h4rryhaller/jarduino/IMG_20260922_170826.jpg

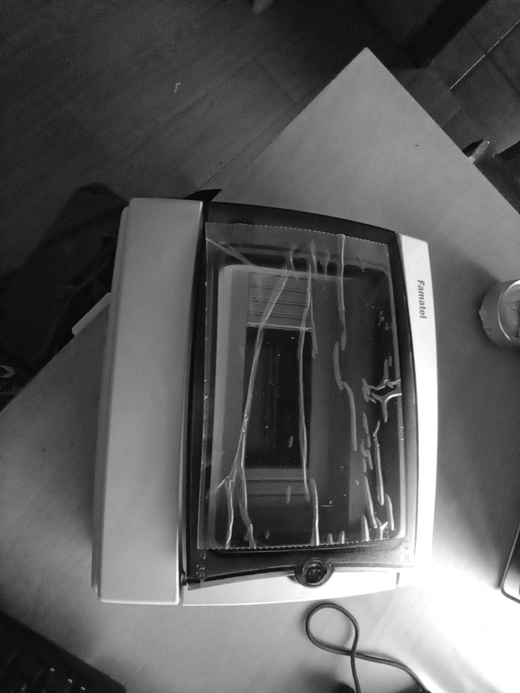
IMG_20260922_170826.jpg
