h4rryhaller/jarduino/IMG_20260922_170915.jpg

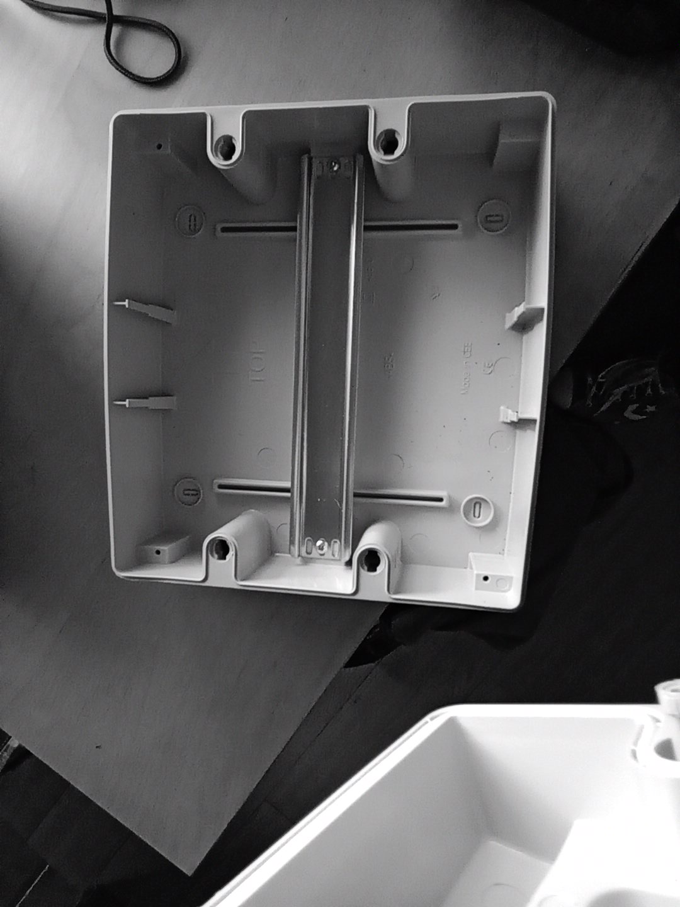
IMG_20260922_170915.jpg
