h4rryhaller/jarduino/IMG_20260922_170907.jpg

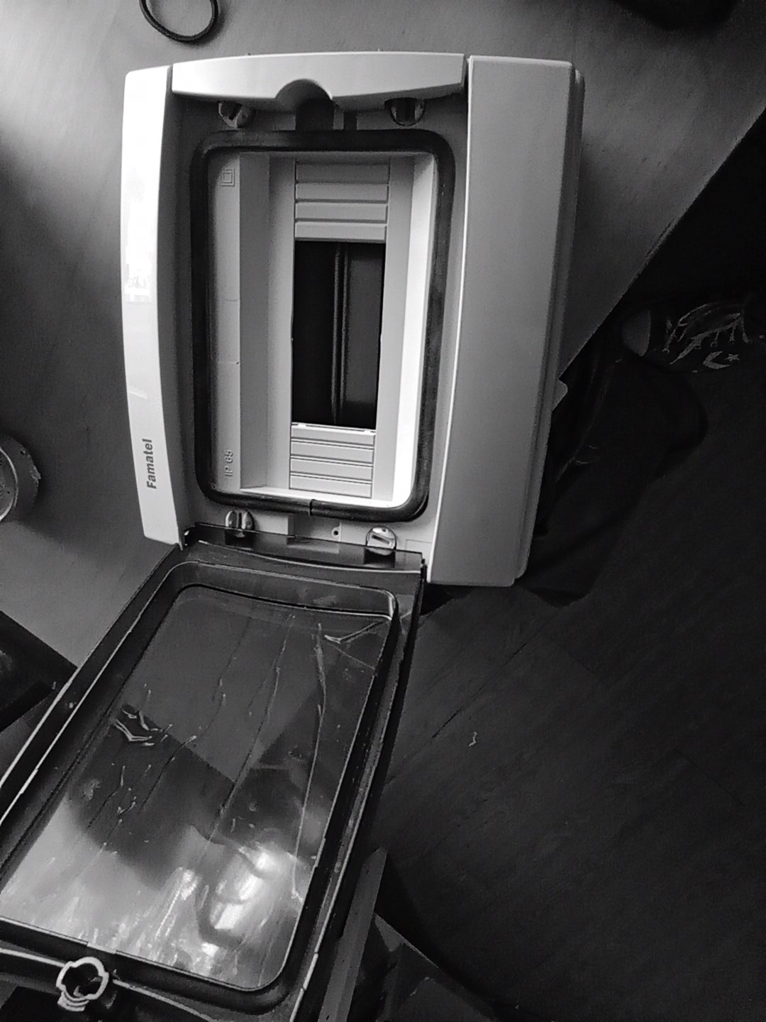
IMG_20260922_170907.jpg
