h4rryhaller/jarduino/IMG_20260922_171056.jpg

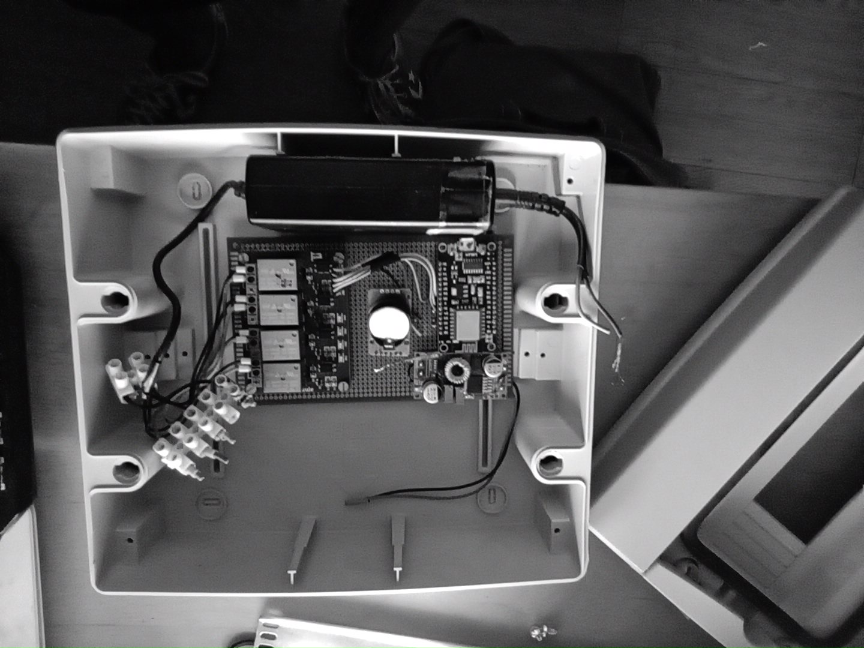
IMG_20260922_171056.jpg
