h4rryhaller/jarduino/IMG_20260922_173857.jpg

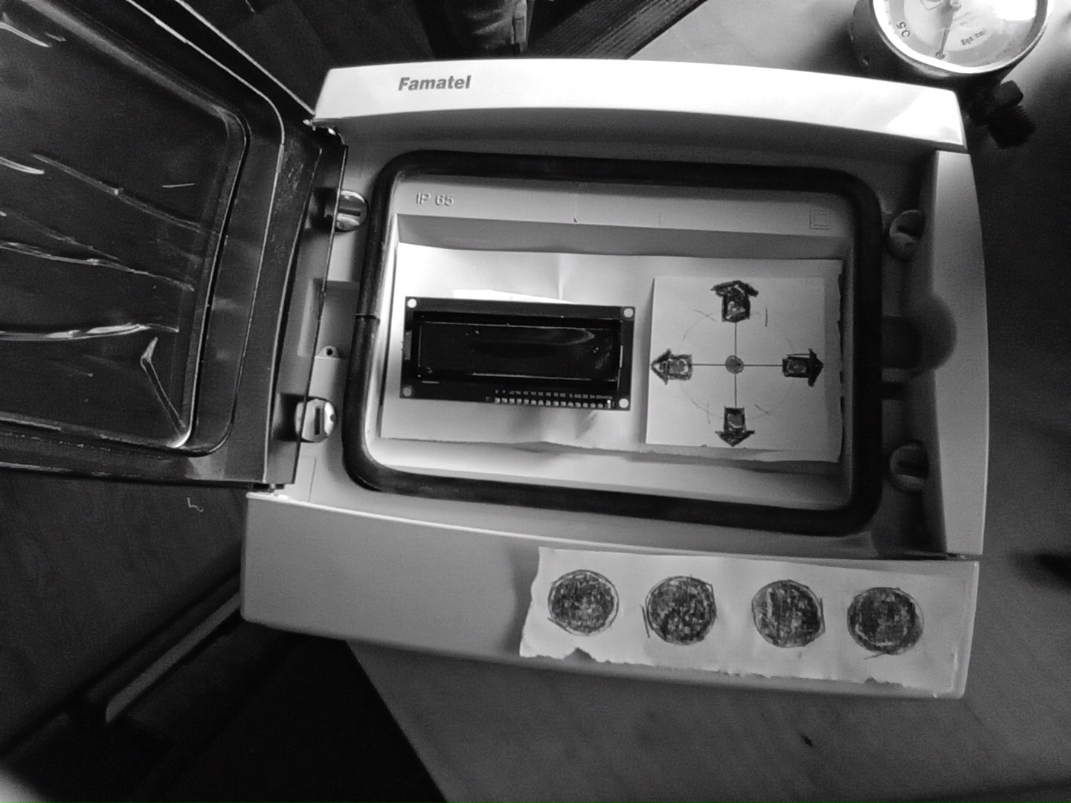
IMG_20260922_173857.jpg
