h4rryhaller/jarduino/IMG_20260922_174004.jpg

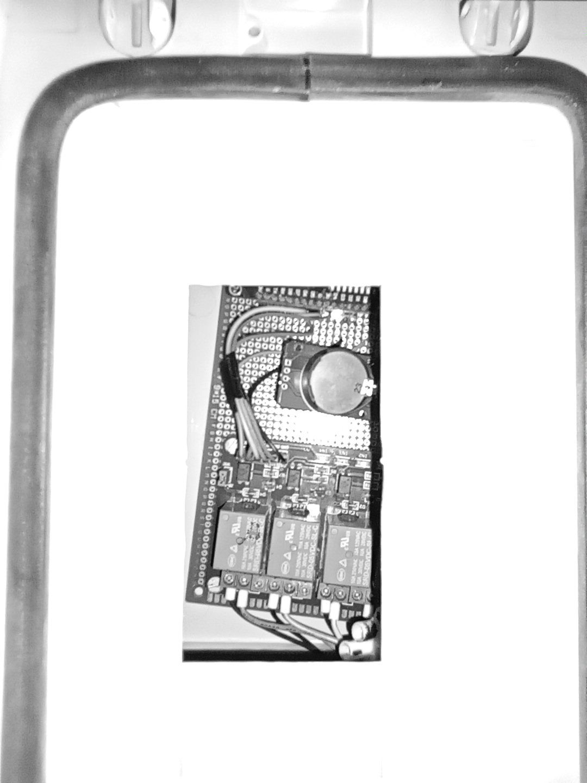
IMG_20260922_174004.jpg
