h4rryhaller/jarduino/IMG_20260922_174008.jpg

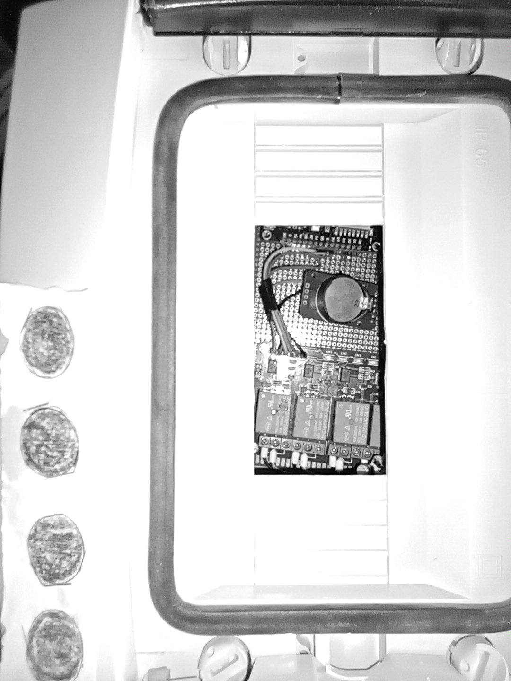
IMG_20260922_174008.jpg
