h4rryhaller/jarduino/jarduino/jarduino.ino

// Jarduino: riego automático de 4 zonas con ESP8266 (NodeMCU).
// Fase 1: todo lo que riega sin red (horarios, reglas de compañía, relés,
// optos, tapa y consola serie).
// Fase 2: WiFi (portal cautivo), NTP (corrige el RTC), API HTTP y mDNS.
// Fase 4: OTA (ArduinoOTA y subida web en /update), nunca con riego activo,
// y la web app en http://jarduino.local/
// El riego nunca depende de la red. Ver README.md del proyecto.

#include <Wire.h>
#include "config.h"
#include "configuracion.h"
#include "riego.h"
#include "reloj.h"
#include "programador.h"
#include "tapa.h"
#include "consola.h"
#include "red.h"
#include "api.h"
#include "ota.h"
#include "web.h"
#include "registro.h"

void setup() {
  riegoIniciar();  // antes que nada: relés apagados

  Serial.begin(115200);
  registro.println();
  registro.println("Jarduino arrancando");

  Wire.begin(PIN_SDA, PIN_SCL);
  riegoIniciarOptos();
  cargarConfiguracion(config);
  tapaIniciar();
  relojTick();

  redIniciar();  // WiFi + NTP + mDNS (puede abrir el portal con timeout)
  apiIniciar();  // API HTTP en el puerto 80
  otaIniciar();  // ArduinoOTA + /update (necesita secretos.h)
  webIniciar();  // web app en /

  registro.println("Listo. Escribe una orden o una linea vacia + E para el estado");
}

void loop() {
  relojTick();
  programadorTick();
  riegoTick();
  tapaTick();
  consolaTick();
  redTick();
  apiTick();
  otaTick();
}
