h4rryhaller/jarduino/jarduino/config.h

#ifndef CONFIG_H
#define CONFIG_H

#include <Arduino.h>

// ---- Bus I2C (SDA=D2/GPIO4, SCL=D1/GPIO5) ----
#define PIN_SDA 4
#define PIN_SCL 5
#define ADDR_LCD     0x27
#define ADDR_BOTONES 0x20
#define ADDR_ZONAS   0x26  // salidas de los optos, activas a nivel bajo
#define ADDR_RTC     0x68

#define NUM_ZONAS 4

// Relés IN1..IN4 = zonas 1..4 (D7, D6, D5, D0; comprobado 2026-09-24).
// Se evitan GPIO0/2/15: un relé que parpadea en el arranque abriría una válvula.
static const uint8_t PIN_RELE[NUM_ZONAS] = {13, 12, 14, 16};
#define RELE_ON  LOW
#define RELE_OFF HIGH

// Bit de la placa de zonas para cada zona. Módulo PCF8574 GERUI (2026-10-02)
// sin serigrafía; la tira va al revés (mapeada con prueba_zonas, 2026-10-25):
// 1.er pin probablemente INT, luego P7, P6, P5, P4... Zona 1 = P4 (5.º pin),
// 2 = P7 (2.º), 3 = P6 (3.º), 4 = P5 (4.º).
static const uint8_t BIT_ZONA[NUM_ZONAS] = {4, 7, 6, 5};

// Bits de la placa de botones (medidos de nuevo tras recolocar los botones, 2026-10-03)
#define BIT_ARRIBA 4
#define BIT_ABAJO  6
#define BIT_IZQ    5
#define BIT_DER    0
#define BIT_CENTRO 2
#define ANTIRREBOTE_MS     30
#define PULSACION_LARGA_MS 800
#define REPETICION_ESPERA_MS 500   // arriba/abajo mantenidos: empiezan a repetir...
#define REPETICION_MS        120   // ...a este ritmo
#define MENU_INACTIVIDAD_MS  60000 // sin tocar nada, el menú vuelve al inicio

// ---- LCD ----
#define LCD_COLUMNAS 16
#define LCD_FILAS    2

// ---- Riego ----
#define PASO_VALVULAS_MS    4000  // entre dos maniobras de válvula (golpe de ariete)
#define OPTO_LECTURA_MS     5     // cada medio ciclo de 50 Hz caen 2 lecturas
#define OPTO_VENTANA_MS     40    // 2 ciclos de red: con tensión siempre se ve un 0
#define OPTO_ESTABLE_MS     300   // antirrebote de la lectura de los optos
#define FALLO_VALVULA_MS    3000  // relé activado y sin tensión en la válvula
#define MARGEN_OPTO_MS      1000  // lo que tarda el opto en seguir a un cambio de relé
#define DURACION_MANUAL_MIN 15    // riego manual desde la tapa
#define DURACION_MAX_MIN    240   // tope de cualquier riego, venga de donde venga

// ---- Persistencia ----
#define CONFIG_FILE_PATH "/config.json"
#define REGISTRO_BYTES   6144  // log en RAM para /api/log (~80-100 líneas)

// ---- Red (fase 2) ----
#define HTTP_PORT       80
#define HOSTNAME        "jarduino"        // DHCP + mDNS -> jarduino.local
#define AP_SETUP        "Jarduino-setup"  // AP del portal cautivo de WiFiManager
#define PORTAL_TIMEOUT_S 300              // si nadie configura el portal, sigue offline
#define TZ_HORARIO      "CET-1CEST,M3.5.0,M10.5.0/3"  // España peninsular, con cambio de hora
#define NTP_SERVER1     "pool.ntp.org"
#define NTP_SERVER2     "time.nist.gov"
#define RTC_RESYNC_MS   86400000UL        // re-sincroniza el RTC con NTP 1 vez/día

#endif
