h4rryhaller/jarduino/jarduino/tapa.cpp

#include <Wire.h>
#include <LiquidCrystal_I2C.hpp>  // la de LCDBigNumbers: .hpp, no .h
#include "config.h"
#include "configuracion.h"
#include "reloj.h"
#include "riego.h"
#include "menu.h"
#include "tapa.h"
#include "registro.h"

static LiquidCrystal_I2C lcd(ADDR_LCD, LCD_COLUMNAS, LCD_FILAS);

static uint8_t seleccion = 0;
static char pintado[LCD_FILAS][LCD_COLUMNAS + 1];
static char mensaje[LCD_COLUMNAS + 1];
static uint32_t mensajeDesdeMs = 0, mensajeDuracionMs = 0;
static uint32_t ultimoRefrescoMs = 0;

static uint8_t lecturaAnterior = 0xFF, estable = 0xFF;
static uint32_t ultimoCambioMs = 0, ultimaLecturaMs = 0, centroDesdeMs = 0;
static bool largaDisparada = false;
static uint8_t bitRepetido = 0xFF;  // arriba o abajo mantenido
static uint32_t proximaRepeticionMs = 0;
static int8_t cursorLcd = -1;       // columna del cursor parpadeante en la línea 2

// La ROM de la LCD no tiene tildes: se quitan; la ñ está en 0xEE
void textoLcd(const char *utf8, char *out, size_t tam) {
  size_t n = 0;
  for (const uint8_t *p = (const uint8_t *)utf8; *p && n < tam - 1; p++) {
    if (*p < 0x80) { out[n++] = *p; continue; }
    if (*p == 0xC3 && p[1]) {
      p++;
      static const char tabla[] = "AAAAAAACEEEEIIIIDNOOOOOxOUUUUYPsaaaaaaaceeeeiiiidnooooo/ouuuuypy";
      out[n++] = (*p == 0xB1 || *p == 0x91) ? (char)0xEE : tabla[(*p - 0x80) & 0x3F];
      continue;
    }
    while ((p[1] & 0xC0) == 0x80) p++;  // otros caracteres de varios bytes
    out[n++] = '?';
  }
  out[n] = '\0';
}

static char simboloZona(uint8_t n) {
  const EstadoZona &z = riegoEstado(n);
  bool quiere = z.pedida || z.porCompania;
  if (z.falloValvula) return '!';
  if (quiere != z.rele) return '~';
  if (z.tension && !z.rele) return 'M';
  if (z.porCompania && !z.pedida) return 'c';
  if (z.rele) return '*';
  return config.zonas[n - 1].activo ? '.' : '-';
}

void estadoCortoZona(uint8_t n, char *buf, size_t tam) {
  const EstadoZona &z = riegoEstado(n);
  if (z.falloValvula) { strlcpy(buf, "err", tam); return; }
  if (z.pedida) {
    uint32_t min = (riegoRestanteSeg(n) + 59) / 60;
    if (min < 100) snprintf(buf, tam, "%2lum", (unsigned long)min);
    else snprintf(buf, tam, "%3lu", (unsigned long)min);
    return;
  }
  if (z.porCompania) { strlcpy(buf, "acp", tam); return; }
  if (z.tension) { strlcpy(buf, "man", tam); return; }
  strlcpy(buf, "off", tam);
}

// Devuelve true si ha escrito algo (y por tanto movido el cursor de la LCD)
static bool escribirLinea(uint8_t fila, const char *texto) {
  char linea[LCD_COLUMNAS + 1];
  snprintf(linea, sizeof(linea), "%-16s", texto);
  if (strcmp(linea, pintado[fila]) == 0) return false;
  strcpy(pintado[fila], linea);
  lcd.setCursor(0, fila);
  lcd.print(linea);
  return true;
}

static void colocarCursor(int8_t columna, bool movido) {
  if (columna < 0) {
    if (cursorLcd >= 0) lcd.noBlink();
    cursorLcd = -1;
    return;
  }
  if (columna == cursorLcd && !movido) return;
  lcd.setCursor(columna, 1);
  if (cursorLcd < 0) lcd.blink();
  cursorLcd = columna;
}

static void pintarMenu() {
  char linea0[LCD_COLUMNAS + 1], linea1[LCD_COLUMNAS + 1];
  int8_t cursor;
  menuPantalla(linea0, linea1, sizeof(linea0), cursor);
  bool hayMensaje = millis() - mensajeDesdeMs < mensajeDuracionMs;
  bool movido = escribirLinea(0, hayMensaje ? mensaje : linea0);
  movido |= escribirLinea(1, linea1);
  colocarCursor(cursor, movido);
}

static void pintar() {
  if (menuActivo()) return pintarMenu();
  colocarCursor(-1, false);
  char linea[LCD_COLUMNAS + 1];

  if (millis() - mensajeDesdeMs < mensajeDuracionMs) {
    escribirLinea(0, mensaje);
  } else {
    char hora[10], nombre[LCD_COLUMNAS + 1], estado[10];
    const Fecha &f = relojAhora();
    if (relojResponde()) snprintf(hora, sizeof(hora), "%02u:%02u%c", f.hora, f.min, relojValido() ? ' ' : '!');
    else strlcpy(hora, "--:--?", sizeof(hora));
    textoLcd(config.zonas[seleccion].nombre, nombre, sizeof(nombre));
    estadoCortoZona(seleccion + 1, estado, sizeof(estado));
    snprintf(linea, sizeof(linea), "%.6s%-6.6s %.3s", hora, nombre, estado);
    escribirLinea(0, linea);
  }

  size_t n = 0;
  for (uint8_t i = 0; i < NUM_ZONAS; i++) {
    linea[n++] = i == seleccion ? '>' : ' ';
    linea[n++] = '1' + i;
    linea[n++] = simboloZona(i + 1);
    linea[n++] = ' ';
  }
  linea[n] = '\0';
  escribirLinea(1, linea);
}

void tapaMensaje(const char *texto, uint32_t ms) {
  textoLcd(texto, mensaje, sizeof(mensaje));
  mensajeDesdeMs = millis();
  mensajeDuracionMs = ms;
  pintar();
}

void tapaPintarAhora(const char *linea0, const char *linea1) {
  colocarCursor(-1, false);
  escribirLinea(0, linea0);
  escribirLinea(1, linea1);
}

static void pulsacionCentro() {
  uint8_t n = seleccion + 1;
  const EstadoZona &z = riegoEstado(n);
  char texto[LCD_COLUMNAS + 1];
  if (z.pedida) {
    riegoDetenerZona(n);
    snprintf(texto, sizeof(texto), "Zona %u: parada", n);
  } else if (z.porCompania) {
    snprintf(texto, sizeof(texto), "Acompanando");
  } else if (z.tension && !z.rele) {
    snprintf(texto, sizeof(texto), "Interruptor man.");
  } else {
    riegoIniciarZona(n, DURACION_MANUAL_MIN * 60UL, Origen::ManualLcd);
    snprintf(texto, sizeof(texto), "Zona %u: %u min", n, DURACION_MANUAL_MIN);
  }
  tapaMensaje(texto);
}

static bool bajado(uint8_t antes, uint8_t ahora, uint8_t bit) {
  return (antes & (1 << bit)) && !(ahora & (1 << bit));
}

static bool subido(uint8_t antes, uint8_t ahora, uint8_t bit) {
  return bajado(ahora, antes, bit);
}

static bool pulsado(uint8_t bit) { return !(estable & (1 << bit)); }

static void tecla(Tecla t) {
  if (menuActivo()) {
    menuTecla(t);
    return;
  }
  switch (t) {
    case Tecla::Izq: seleccion = (seleccion + NUM_ZONAS - 1) % NUM_ZONAS; break;
    case Tecla::Der: seleccion = (seleccion + 1) % NUM_ZONAS; break;
    case Tecla::Centro: pulsacionCentro(); break;
    case Tecla::CentroLargo: menuAbrir(); break;
    default: break;  // arriba/abajo no hacen nada en la pantalla de inicio
  }
}

static void leerBotones() {
  if (millis() - ultimaLecturaMs < 10) return;
  ultimaLecturaMs = millis();
  if (Wire.requestFrom((uint8_t)ADDR_BOTONES, (uint8_t)1) != 1) return;
  uint8_t lectura = Wire.read();

  if (lectura != lecturaAnterior) {
    lecturaAnterior = lectura;
    ultimoCambioMs = millis();
  }
  if (lectura != estable && millis() - ultimoCambioMs >= ANTIRREBOTE_MS) {
    uint8_t antes = estable;
    estable = lectura;
    mensajeDuracionMs = 0;  // cualquier botón quita el mensaje
    if (bajado(antes, estable, BIT_IZQ)) tecla(Tecla::Izq);
    if (bajado(antes, estable, BIT_DER)) tecla(Tecla::Der);
    // Arriba y abajo se repiten mientras se mantienen (para cambiar valores)
    if (bajado(antes, estable, BIT_ARRIBA) || bajado(antes, estable, BIT_ABAJO)) {
      bitRepetido = bajado(antes, estable, BIT_ARRIBA) ? BIT_ARRIBA : BIT_ABAJO;
      proximaRepeticionMs = millis() + REPETICION_ESPERA_MS;
      tecla(bitRepetido == BIT_ARRIBA ? Tecla::Arriba : Tecla::Abajo);
    }
    if (bajado(antes, estable, BIT_CENTRO)) {
      centroDesdeMs = millis();
      largaDisparada = false;
    }
    if (subido(antes, estable, BIT_CENTRO) && !largaDisparada) tecla(Tecla::Centro);
    pintar();
  }

  if (bitRepetido != 0xFF) {
    if (!pulsado(bitRepetido)) {
      bitRepetido = 0xFF;
    } else if ((int32_t)(millis() - proximaRepeticionMs) >= 0) {
      proximaRepeticionMs += REPETICION_MS;
      tecla(bitRepetido == BIT_ARRIBA ? Tecla::Arriba : Tecla::Abajo);
      pintar();
    }
  }

  if (pulsado(BIT_CENTRO) && !largaDisparada && millis() - centroDesdeMs >= PULSACION_LARGA_MS) {
    largaDisparada = true;
    tecla(Tecla::CentroLargo);
    pintar();
  }
}

void tapaIniciar() {
  lcd.init();
  lcd.backlight();
  pintado[0][0] = pintado[1][0] = '\0';

  Wire.beginTransmission(ADDR_BOTONES);
  Wire.write(0xFF);  // entradas con pull-up débil
  if (Wire.endTransmission() != 0) registro.println("La placa de botones (0x20) no responde");
  tapaMensaje("Jarduino", 1500);
}

void tapaTick() {
  leerBotones();
  menuTick();
  if (millis() - ultimoRefrescoMs >= 250) {
    ultimoRefrescoMs = millis();
    pintar();
  }
}
