h4rryhaller/jarduino/jarduino/web.h

#ifndef WEB_H
#define WEB_H

// Web app en http://jarduino.local/ : una sola página (HTML, CSS y JS en la
// flash, en web.cpp) que usa la API HTTP. Se actualiza con el firmware (OTA).
void webIniciar();  // tras apiIniciar()

#endif
