h4rryhaller/jarduino/(commit log)

2026-09-24 Jarduino: documentación de diseño y tapa (LCD + 5 botones) probada
    - README y documento de diseño con hardware, pines, zonas, API, OTA y
    formato de config.json (config.json.example).
    - Bus I2C de la tapa verificado: LCD en 0x27, botones en 0x20 (la placa
    de zonas irá en 0x21). Tapa entera a 5 V, 4 hilos por la bisagra.
    - Botones: centro=P5, derecha=P4, arriba=P2, izquierda=P1, abajo=P0
    (esta mochila no sigue el orden habitual).
    - Sketches de prueba: i2c_scanner (escaneo + lectura de botones) y
    prueba_tapa (LCD + botones con antirrebote). Incluyen
    <LiquidCrystal_I2C.hpp> de LCDBigNumbers para evitar el error de enlazado.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
    [i2c_scanner.ino, prueba_tapa.ino]
2026-09-24 Jarduino: prueba de RTC y relés, mapeo definitivo de botones y relés
    - prueba_rtc_reles: hora del DS3231 en la LCD (lectura/escritura directa
    por I2C, puesta en hora por serie con "T2026-09-24 18:30:00"), y
    control de los 4 relés con los botones de la tapa, con apagado
    automático a los 30 s.
    - Relés medidos con polímetro, zona n = relé n: IN1=D7, IN2=D6, IN3=D5,
    IN4=D0. Pila del RTC verificada.
    - Botones confirmados tras soldarlos (sin cambios de código, solo
    comentarios y documentación).
2026-09-27 Jarduino: placa de zonas en 0x26 y lectura de los optoacopladores
    - PCF8574 de zonas en 0x26 (solo A0 puenteado) en vez de 0x21.
    - prueba_rtc_reles lee la placa de zonas y muestra por serie cada bit
    que cambia ("P0 -> 0 (con tension)").
    - Módulo opto Hailege: salida activa a nivel bajo y sin pull-up propio;
    con el pull-up del PCF8574 baja a 0,4 V. Zona 1 = P0; P3 siempre a 0
    (retroiluminación de la mochila), se ignora.
2026-09-27 Jarduino: mapeo de los 4 optoacopladores, hardware verificado en banco
    - Zonas 1-4 = P4, P2, P1, P0 de la placa de zonas (0x26); P3 se ignora
    (retroiluminación de la mochila, siempre a 0).
    - prueba_rtc_reles muestra el opto por número de zona.
    - Verificados: tapa (LCD + botones), RTC con pila, 4 relés y 4 optos.
2026-09-27 Jarduino: firmware fase 1, núcleo de riego sin red
    config.json en LittleFS, RTC, horarios, relés escalonados con la regla de
    compañía del jardín, optos (interruptor manual y fallo de válvula),
    pantalla de inicio de la tapa y consola serie para probar en el banco.
2026-09-27 Jarduino: la placa de zonas informa siempre de su estado al arrancar
    Antes solo avisaba al pasar de responder a no responder, así que si no
    respondía desde el arranque no salía nada. Además se configura como
    entradas (0xFF) al arrancar, igual que la de botones.
2026-10-01 Jarduino: causa del fallo de la placa de zonas, prueba_zonas y fotos
    - La mochila de zonas (0x26) fallaba en el montaje final por una
    soldadura defectuosa en VCC; sola funcionaba alimentada por el bus.
    - GND de salida del módulo de optos al pin 1 (VSS) de la mochila.
    - Mejoras futuras: detección de fugas (caudalímetro, válvula general,
    sensor de presión).
    - Sketch prueba_zonas y fotos del prototipo.
2026-10-01 Jarduino: mochila de zonas descartada, pendiente de una nueva
2026-10-01 Añadir .gitignore (ignora config.json real y artefactos de build)
2026-10-02 Mapeo de zonas al nuevo módulo PCF8574 GERUI (zona n -> P(n-1))
    Sustituida la mochila de LCD rota por un módulo PCF8574 con jumpers en 0x26.
    Al sacar P0-P7 directos se recablea limpio (zona 1=P0 .. zona 4=P3) y ya no
    hay que evitar P3. Probado en banco: arranque OK, optos responden, relés y
    detección de fallo funcionando.
2026-10-02 Firmware fase 2: WiFi + NTP + API HTTP + mDNS
    - red.*: WiFiManager (portal cautivo), mDNS (jarduino.local) y NTP que
    corrige el RTC al conectar y 1x/dia. Reconexion automatica; el riego
    sigue sin red.
    - api.*: ESP8266WebServer en el puerto 80 con todos los endpoints del
    contrato (status, datetime, riego iniciar/detener/detener-todo, sistema).
    Errores {"error","detalle"}, rutas con parametro via UriBraces.
    - consola: comando W (estado WiFi: SSID, IP, RSSI, NTP).
    - jarduino.ino: redIniciar/apiIniciar en setup, redTick/apiTick en loop.
    Probado sobre hardware real por WiFi: todos los endpoints OK, incluidos
    casos de error. NTP corrige el RTC. Aviso: RSSI muy bajo en el banco,
    hara falta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
    [api.cpp, api.h, config.h, consola.cpp, consola.h, jarduino.ino, red.cpp, red.h]
2026-10-03 Nuevo mapeo de botones de la tapa tras recolocarlos
    Medido el 2026-10-03: arriba = P4, abajo = P6, izquierda = P5,
    derecha = P0, centro = P2. Actualizado en el firmware, los sketches
    de prueba y la documentación.
    prueba_tapa ignora P3 (retroiluminación, siempre a 0) y amplía el
    texto para que "P0 izquierda" no se corte.
2026-10-03 Anotar el pin del conector de 16 del botón abajo (P6 = pin 4)
2026-10-03 Programador: lanzar la ventana nueva si se cambia el horario el mismo día
    Se apuntaba solo el día en que se había lanzado el riego automático de cada
    zona, así que tras regar con un horario cualquier horario nuevo de ese día
    se ignoraba hasta el siguiente. Ahora se guarda también el horario lanzado.
2026-10-03 Firmware fase 3: menú de la tapa
    Centro largo abre el menú: Zonas (inicio, fin, días, regar ahora, parar),
    Parar todo, Fecha y hora y Sistema. Arriba/abajo se repiten al mantenerlos
    y el campo en edición lleva cursor parpadeante. Vuelve al inicio tras 60 s
    sin tocar nada. Pendiente de probar en la tapa.
2026-10-03 README: menú de la tapa probado en el hardware
2026-10-10 README: cableado del opto y su limitación (mide en la caja, no en la válvula)
2026-10-10 README: válvulas de 24 V AC, rediseño de la alimentación tras morir el Dell
2026-10-10 README y diseño: bits de zonas del módulo PCF8574 GERUI (zona n = P(n-1))
2026-10-18 README: alimentación montada (transformador 24 V AC 30 VA, cargador Xiaomi 5 V) y diodo de los optos en serie
    - Transformador de 30 VA (27,5 V AC en vacío), fusible de 1,25 A en el rojo
    y negro como común sin fusible.
    - Lógica con un cargador Xiaomi de 5 V / 3 A; nota sobre la GND común con el
    NodeMCU (causa de que el escáner I²C no viera ninguna placa).
    - Corrige el 1N4007 de los optos: en serie con IN+, no en antiparalelo
    (cortocircuitaría el transformador). Resistencia de entrada de 3 kΩ: vale
    con los ~39 V de pico.
2026-10-18 Optos: filtro del parpadeo de 50 Hz por firmware y diseño actualizado a 24 V AC
    - leerOptos() lee cada 5 ms y da tensión si ve un 0 en una ventana de 40 ms
    (OPTO_LECTURA_MS, OPTO_VENTANA_MS). Antes leía cada 20 ms, un ciclo de red
    exacto, y con 24 V AC muestreaba siempre la misma fase.
    - Documento de diseño: alimentación actual (transformador 24 V AC 30 VA con
    fusible, cargador Xiaomi 5 V, GND común), diodo de los optos en serie con
    IN+, válvulas de 24 V AC; el Dell y el XL4005 quedan como historial.
2026-10-25 Zonas: mapeo real de la tira del PCF8574 GERUI y antirrebote solo con sus bits
    La tira no tiene serigrafía y va al revés: mapeada con prueba_zonas, el
    primer pin no es de puerto (probablemente INT, se tomó por un P0 averiado)
    y siguen P7, P6, P5, P4. Zonas 1-4 = P4, P7, P6, P5.
    leerOptos() aplica el antirrebote solo a los bits de las zonas, para que un
    pin libre que oscile no impida actualizar ninguna zona.
    prueba_zonas: el escaneo del bus ya no se imprime cada 2 s (TRAZA_ESCANEO)
    y el puerto se imprime cada 2 s aunque no cambie.
2026-10-25 OTA: ArduinoOTA y subida web en /update, nunca con riego activo
    - ota.*: ArduinoOTA (puerto de red "jarduino" en el IDE) y POST /update con
    autenticación básica; las dos con la clave de secretos.h (fuera de git,
    plantilla en secretos.h.example).
    - Con agua abierta no se acepta ninguna subida: la web responde 409
    riego_activo y el IDE no recibe respuesta.
    - Progreso en la LCD con tapaPintarAhora(), porque la subida bloquea el loop.
    - README: sección OTA y fase 4.
2026-10-25 Web app, registro y consola por WiFi
    - web.*: web app en http://jarduino.local/ dentro del firmware (se
    actualiza con la OTA): estado de cada zona, regar/detener, parar todo,
    edición de nombre y horario, avisos de reloj, optos y conexión, panel de
    sistema, registro y consola.
    - registro.*: todo lo que se escribía por Serial pasa por `registro`, que
    además lo guarda con la hora del RTC en un búfer circular de 6 KB.
    GET /api/log lo sirve en texto plano.
    - consola: consolaEjecutar() escribe en un Print, así sirve igual por el
    puerto serie y por POST /api/consola.
    - riego: se quita la traza "con/sin tension"; solo se registra la apertura
    con el interruptor manual y el fallo (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
